ole00/zd-20u/(commit log)

2017-10-07 added schematic image
2017-10-07 added schematics
2017-10-08 added an image of the modded iron in-use on the medium heat mode
2017-10-18 version 1.1 - new heat values
    The values in Centigrades are roughly (low, mid ,full):
    Heat 1: 200, 250, 330
    Heat 2: 230, 265, 330
    Heat 3: 240, 280, 330
    Heat 4: 250, 290, 330
    temeprature values depend on many factors like
    quality / rating of the probe and thermometer (I have very basic one),
    dirt on the soldering tip, size of solder blob on the tip
    and how well it touches the probe, size / mass of the probe,
    ambient temperature, voltage and current in your battery etc.
2017-10-18 added info about temperatures to README.md
2022-02-21 Updated Readme.md
    changed wording
    changed value of the LED resistor to 300 - 1k Ohm
    updated SOIC clamp ebay page
